tauntonme/General/Electronics Hardware/Signals Controller/DaisyCore/Daisies3.jpg

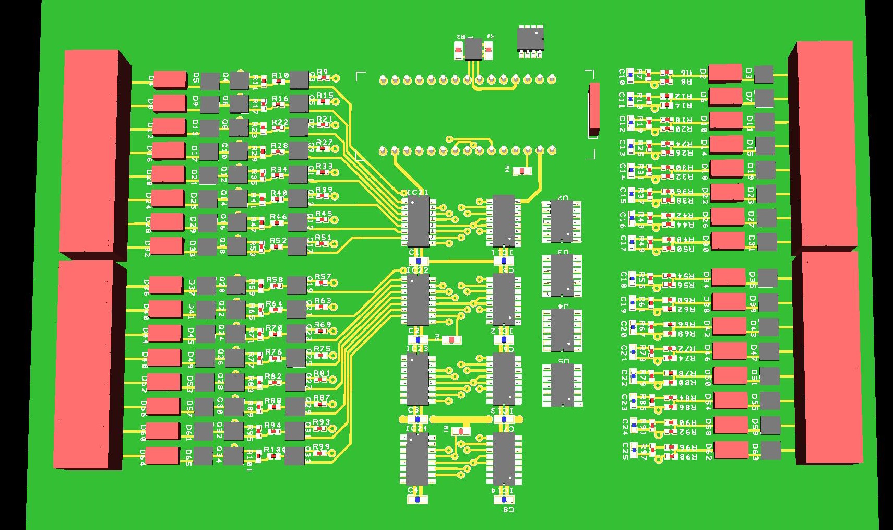
Electronics Hardware/Signals Controller/DaisyCore/Daisies3.jpg
