tauntonme/General/README.md

# General
First landing place for all files for now, will refine later maybe

Created by Jon Freeman
23rd May 2023
