tauntonme/General/Electronics Hardware/Signals Controller/DaisyCore/Daisy.odt

West Buckland Railway Signalling System

System Architecture Overview

The purpose of the Signalling System is to promote safer working of the railways.

Signalling. A Control System.

The railway is made up of a number of discrete connected ‘objects’; track sections, turnouts, crossing gates, lineside railway signals, train presence or movement detectors to name a few, and the ‘whatever it is that makes it all work’ controller(s).

A control system monitors the state of ‘objects’, and determines the future state of these and other objects in accordance with some predetermined plan, or ‘programme’. This, in essence, describes any control system whether a railway signalling system, oil refinery, or other process.

There’s plenty that moves on a railway, apart from trains! Gates, turnouts and semaphore signals, for example. To keep collision numbers low, the signalling system needs to ‘know’ for certain where all these moving items are at any time.

You might imagine that as the signalling system directs the settings of semaphores and turnouts, a simple one-wire ‘On/Off’ command

The simplest approach to controlling these might involve switching power along single wires to move object parts, in the hope that a semaphore moves between showing ‘Clear’ or Danger’, a turnout moves from setting ‘Safe Route A’ to setting ‘Safe Route B’, a gate moves between being fully open to fully shut, with power sent along the appropriate wire, or not.

There’s plenty to go wrong here. A gull sitting on a semaphore blade, a pebble stuck in a turnout, something blocking a gate, a semaphore missing altogether – the controller needs to know!

Object parts may be moved using motors, solenoids, pneumatics, or something else. There may be the need to drive actuators in both directions, requiring at least a two-wire control – two outputs from the controller. For the controller to be certain of the position objects are in, two inputs to the controller are required (see ‘Moving Part Rule’ and ‘Standard Interface’ for details). This 2-in, 2-out requirement uses ‘4IO’ in the jargon. Using the ‘Standard Interface’, 4 controller ‘IO’ lines need to be allocated to each moving object.

A quick count-up for a rough guide to controller ‘IO’ requirement : - 8 turnouts, maybe 18 semaphore or coloured light equivalent lineside signals, 4 crossing gates = 30 objects requiring a total 120 IO.

A lineside railway signal may, for example, indicate “Clear” or “Danger”. Having no means within itself to determine which aspect to display, it obeys a command decision issued to it by a ‘controller’, which uses knowledge of the states found in the wider system in reaching its decision.

For semaphore signals, and other objects with moving parts, the controller will also need to ‘know’ the part has moved correctly and fully to the required position. Movement command and position feedback between controller and remote ‘object’ typically uses four wires, two input and two output (“4 IO” to use the jargon) as detailed in ‘Standard Interface link’.

Turnouts (points). The controller constantly needs to know with certainty the turnout is ‘In Position A’, is ‘In Position B’, or in neither of the above! Semaphore signals, mechanical interlocks and crossing gates are other examples of objects that the controller needs to know the position state of. Consideration of these led to the ‘Moving Part Rule’ for safely reporting positions back to the controller. Whatever means of setting turnout position is decided upon, there will be times when attempted setting fails (pebble stuck in works?). One task of the SigSys is to ensure failures of this and similar types are dealt with safely.

Electronics and Controllers

Safe running of the railway relies upon factors both within, and beyond our field of influence. While design and testing of signalling system outputs will be rigorously tested and formed to comply with agreed requirements, it is inevitable ‘Signals At Danger’ will be passed, and unmonitored other hazards will arise.

hite

Controllers and Peripherals

Lineside driver-info signals, turnouts determining route, level crossing, signal box levers – these system component parts are the ‘peripherals’.

Monitoring and changing the states of peripherals will be one or more ‘controller’.

The Signalling System comprises ‘Controllers’ and ‘Peripherals’.

A controller has a point-to-point, two-way communication channel with each peripheral within its world view. Peripherals communicate with one controller only. This describes a ‘Star Network (https://en.wikipedia.org/wiki/Star_network)’.

The signalling system design and build will evolve, and is likely to include more than one controller. The controllers will also be considered a ‘Star Network’, with one designated the central hub. Thus there are at most three levels of hierarchy.

Comms between controllers requires some protocol for interchange of messages of variable lengths and types, deliverable over a physical layer being CAN bus or other two-wire or radio serial bus, or combination thereof.

Most peripherals are very simple, having no ‘intelligence’, and tend to be positioned close to a controller. It makes sense to hard-wire simple nearby peripherals to the controller. To this end, a ‘Standard 2-in-2-out Interface (https://jons-workshop.com/wbsigs/std_interface.html)’ is presented (see also the Moving Part Rule (https://jons-workshop.com/wbsigs/moving_part_rule.html).)

Cable Connections

Electrical signal-wire connections will be used between items distributed around a ‘harsh environment’, with attendant risk to electrical signal and cable integrity. Electrical interfaces will be designed such that a cable fault between a controller and a peripheral, however caused, will : -

- cause no damage to interfaces in the controller or the peripheral
- affect only the connected peripheral

The one exception to be partial or total power failure. Power is likely to be distributed using a power distribution network, separate from controller network cabling. Cable faults on the power network may shut down the whole system, the cost of alternative power distribution topologies being prohibitive.

West Buckland Railways - Signalling

Standard Control Interface – Electrical Specification

Jon Freeman 30th March 2023

This document contains the electrical specifications of electrical Input and Output ports of Controllers and Peripherals used in the signalling system.

Design considerations : -

(Reference to ‘signal’ in this section means ‘electrical signal’.)

Notes on WBSIG ‘Daisy’ Controller

Jon Freeman Feb 2023

This describes the West Buckland Railway signalling system sub-assembly ‘Daisy’.

The unit features a controller, connected to a number of input and output connections.

Inputs are used to monitor limit switches or other sensors providing feedback of information about the physical positions of things such as gates, levers, turnout settings, semaphores etc.

Outputs may be used to drive coloured light or semaphore signals, actuators for gates and turnouts etc.

The controller will set outputs according to the current state of inputs, as determined by a set of instructions distilled from the collective wisdom of club members..

SIPO - Serial in, parallel out

PISO - Parallel in, serial out

A Nucleo L432KC ARM Cortex controller is connected to a pair of daisy-chains of shift registers : -

- SIPO Chain - Provides Logic Outputs useful for powering lights, actuators etc
- PISO Chain - Reads and stores Logic Inputs from limit switches etc.

The SIPO chain uses 74HC595 serial-in parallel-out shift registers.

The PISO chain uses 74HC597 parallel-in serial-out shift registers.

Chain length can in principle be any (on this board, four 8-bit registers are used in each chain giving 32 input and 32 output bits).

The controller loads the output registers, and reads the input registers simultaneously using an internal SPI engine (Serial Peripheral Interface), under interrupt control. This reduces overhead to almost nothing (does not tie-up the processor clocking bits in and out).

595 SIPO - for Outputs

Comprises : -

8 stage SIPO shift register

8 bit storage registers

8 bit tri-state output buffer

Inputs

DS from controller MOSI or Q7 of previous stage, Data Serial In to shift reg

SHCP Shift Clk __-- moves bits along shift register

MR\ Clear shift reg only contents

STCP Storage register strobe _- updates from shift reg output

OE\ Output enable, active Lo

Outputs

Q0-Q7 8 bit tri-state buffer outputs

Q7S Shift reg MSB out to DS of following stage

597 PISO - for Inputs

Comprises : -

8 bit input register, feeding

8 bit shift register

13 Inputs

D0-D7 8 bit input

STCP storage register clk, _- loads 8 bit input to shift register

MR\ Async reset

DS Data in from previous stage

PL\ Async load shift reg from storage reg

SHCP shift register clk _-

1 Output

Q7 to controller MISO or DS input of next stage in chain

SHCP

For both ‘595 and ‘597, _- shift register clock from SPI_SCLK

STCP

For ‘595 outputs. _- clocks shift reg data onto outputs

For ‘597 inputs, _- clocks data into input flip flops

PL\

‘597 input only. Active low async parallel load shift reg from input register. This could be combined with STCP if STCP idles hi ------_----, except that PL\ becomes active after falling edge, inactive on rising edge when later info updates input flip flops. This means input flip flops always read data one cycle later, although STCP could be driven ----_-_---- where the extra rising clock edge transfers latest input data, double clocking output data has no effect.

MR\ (‘597 input and ‘595 output)

Async master shift register reset. Good practice, perhaps, to pull low during power-up. To remain hi in normal use. Probably good to tie to NRTS. R4, R5, C9 provide options.

OE\ (‘595 output only)

Pull low, use 1k resistor. Do not expect problems with outputs enabled at all times, pull-down keeps options open.

West Buckland Railway Signalling Project

All About Controllers

The signalling system uses one or more controllers programmed to our needs. The heart of any controller box will be a small central mini-computer with few connections. Strings, or ‘daisy chains’ of shift-registers are used to provide any practical number of ‘input’ and ‘output’ connections to monitor and control the wider system. Referring to Fig “Controller Core”, the mini-computer is a low cost (£10) module U1 STM32L432KC. It connects to; IC1 a memory to store local setup info, IC3 a CAN bus interface enabling communication between controllers, and to the right two ‘daisy chains’ of shift registers enabling reading and setting of any practical number of input and output connections (two chains of four eight-bit registers shown, providing 32 inputs and 32 outputs. Daisy chains may be any practical length for any practical number of connections).

Controller Input and Output Interface Circuits

The tiny electrical signals powering modern digital systems need a good degree of protection and isolation from the Big Bad World, to and from which they ultimately communicate. This is the job of the input and output interface circuits.

Q. How much money do we want to spend on In/Out interfacing?

A. While not driven as a ‘cost sensitive’ project, the total number of inputs and outputs proposed has been greatly inflated by our accommodation of a lot of extra mechanical hardware. Raised track requirements are trivial, but long before design of the ground-level system is anywhere near complete, combined I/O requirements exceed one hundred – a penny saved on I/O design saves the club > £1.

Agreed early on, the highest voltage used in the signalling system is +50V DC (negative earth). Input and output circuits will be designed to withstand max system voltages being wrongly applied.

Faulty connection of any input or output is to cause no damage, and have no effect on any other input or output. Allowing for a +50% voltage safety margin, there should be no need to resort to costly hardware such as opto-isolation, multiple floating I/O supplies etc.

Source(s) and Sink(s).

These are terms used in discussion of controller inputs and outputs. Simply, a ‘source’ is an electrical terminal capable of ‘sourcing’ a conventional current flow towards a more electrically negative terminal, the ‘sink’. Conventional current is said to flow from positive, to negative. Current flows from source, to sink. Just like water and taps, no more difficult than that.

Should our inputs and outputs be ‘sources’ or ‘sinks’ ?

As a design nicety, we will specify that any input should correctly read any output to which it may be connected. This implies one is a ‘source’, the other a ‘sink’. It makes not a scrap of difference which. Controllers in the West Buckland Signalling system will use current source outputs, and current sink inputs. What this means : -

Inputs sink current. Unconnected inputs or those with zero (or a very small) current flowing into the input connection will be seen by the controller as a logic ‘0’. A positive voltage (in the range around +8 to + 80 volts) applied to the input causes sufficient current to flow into the input sink for the controller to read it as logic ‘1’. What these logic levels mean in terms of signalling will depend upon expressions forming the control algorithm used to determine signalling system behaviour, not our concern here.

Outputs source current. When the controller sets an output bit to ‘1’, current may be drawn from that output connection – e.g. connect an LED between the output pin and earth, current flows, LED lights. With the output bit set to ‘0’, no current flows, LED is dark.

Circuit Protection

Input and output circuits must not be damaged by wrong connection or cable faults. Outputs will be limited in the power they may ‘source’, as it is not reasonable to expect a controller to power any size and type of load a user might one day decide to connect. Rather the outputs will be specified sufficient to power small loads directly, and to operate higher power loads using power switching circuits local to the load, as is good practice.

Inputs and outputs utilise DC, positive with respect to ‘ground’ (negative earth). Protection will be rated to continuously withstand short circuits on individual inputs and outputs to potential points between 0 and +75V (for short term ‘ESD’ ratings see component data sheets).

Interface Design – refer to figure “WBSigs_IO_detail”.

Input Interface Circuit Design

Inputs are designed to sink currents up to 5.6mA (+/- 20%). This is defined and limited using current regulator diodes CL05M6F (See datasheet (https://www.mouser.co.uk/datasheet/2/849/cl05m6f-2577303.pdf)). Referring to Fig “WBSigs_IO_detail”, D2 is an input current regulator, D3 is a plain diode protecting against reverse polarity voltages applied to inputs. Resistor network R6-8 convert input current to a low level voltage fed to Schmitt trigger (https://en.wikipedia.org/wiki/Schmitt_trigger) 74HC14, which buffers the input signal and presents it to the input shift registers. This provides some hysteresis to overcome any noise present on input wiring, meaning the input may read as a logic ‘1’ when input current rises above about 4mA but will not revert to ‘0’ until input current falls below around 2.5mA. Capacitor C10 filters out higher frequencies – prevents interference from radio and other noisy electrical equipment.

Output Interface Circuit Design

Outputs are designed to source currents up to about 15mA, limited by current regulator diode D4 (CL15M35, see data (https://www.mouser.co.uk/datasheet/2/849/cl20m35-2845309.pdf)). This choice ensures an input connected directly to an output, will read the true state. Referring to the circuit, transistor Q3 and resistor R9 form a switched current sink capable of sinking about 1mA when the connected output shift register bit is set to ‘1’. This is sufficient to bias transistor Q4 ‘on’, enabling it to source currents in excess of 15mA. D4 limits current to safe levels. D5 protects against output shorts to high voltage.

Note this input and output circuitry is about as simple as possible consistent with safety and protection requirements, interface component costs of the order of <£2 per IO pair. This is replicated for the number of inputs and outputs, apart from the 74HC14, a hex Schmitt trigger, which can route 6 input bits to the input shift registers. (One of six inverters per 74HC14 shown).
