tauntonme/General/Electronics Hardware/Signals IO Expander/DaisyIOFINAL/plots/DaisyIOFINAL (Plot Report).htm

## Plot Report

Report Written: | Wednesday, May 31, 2023
Project Path: | C:\EasyPC_Projects_Oct22\DaisyIOFINAL\DaisyIOFINAL.prj
Design Path: | C:\EasyPC_Projects_Oct22\DaisyIOFINAL\DaisyIOFINAL.pcb
Design Title:
Created: | 28/05/2023 11:32:32
Last Saved: | 31/05/2023 15:01:09
Editing Time: | 3738 min
Units: | thou (precision 0)

## Device Settings

### Gerber Settings

Leading zero suppression.
G01 assumed throughout.
Line termination <*> .
3.5 format absolute inches.
Format commands defined in Gerber file.
Aperture table defined in Gerber file.
Hardware arcs allowed.

### Drill Settings

Excellon Format 2
Format 3.5 absolute in inches.
Zero suppression Leading

## Plots Output

### Gerber Output

C:\EasyPC_Projects_Oct22\DaisyIOFINAL\Plots\DaisyIOFINAL - Top Silk.gbr

Layers:
Top Silk

D-Code | Shape (thou)
D14 | Round 3.94
D18 | Round 7.87
D19 | Round 5.00
D70 | Round 15.75

### Gerber Output

C:\EasyPC_Projects_Oct22\DaisyIOFINAL\Plots\DaisyIOFINAL - Top Copper.gbr

Layers:
Top Copper

D-Code | Shape (thou)
D23 | Round 15.00
D24 | Round 48.00
D25 | Round 25.00
D26 | Round 50.00
D27 | Round 56.00
D29 | Square 45.00
D72 | Rectangle 40.00 X 48.00 Rotation 90
D73 | Rectangle 40.00 X 44.00
D74 | Square 76.77
D75 | Round 76.77
D76 | Round 63.19
D90 | Rectangle 61.02 X 78.74 Rotation 90
D91 | Rectangle 39.37 X 42.91 Rotation 90
D98 | Round 100.00
D99 | Round 40.00
D100 | Round 20.00
D101 | Round 150.00
D102 | Round 260.00
D103 | Rectangle 180.00 X 460.00 Rotation 90
D104 | Round 96.00
D105 | Rectangle 27.56 X 61.02 Rotation 90
D106 | Square 63.00
D107 | Round 55.00

### Gerber Output

C:\EasyPC_Projects_Oct22\DaisyIOFINAL\Plots\DaisyIOFINAL - Top Resist.gbr

Layers:
Top Resist

D-Code | Shape (thou)
D10 | Round 58.00
D11 | Round 66.00
D78 | Square 55.00
D79 | Rectangle 50.00 X 58.00 Rotation 90
D80 | Rectangle 50.00 X 54.00
D81 | Square 86.77
D82 | Round 86.77
D83 | Round 73.19
D94 | Rectangle 71.02 X 88.74 Rotation 90
D95 | Rectangle 49.37 X 52.91 Rotation 90
D108 | Round 270.00
D109 | Round 106.00
D110 | Rectangle 37.56 X 71.02 Rotation 90
D111 | Square 73.00
D112 | Round 65.00

### Gerber Output

C:\EasyPC_Projects_Oct22\DaisyIOFINAL\Plots\DaisyIOFINAL - Bottom Copper.gbr

Layers:
Bottom Copper

D-Code | Shape (thou)
D23 | Round 15.00
D24 | Round 48.00
D25 | Round 25.00
D26 | Round 50.00
D27 | Round 56.00
D72 | Rectangle 40.00 X 48.00 Rotation 90
D73 | Rectangle 40.00 X 44.00
D74 | Square 76.77
D75 | Round 76.77
D76 | Round 63.19
D88 | Rectangle 27.56 X 76.77 Rotation 90
D89 | Rectangle 40.00 X 44.00 Rotation 90
D90 | Rectangle 61.02 X 78.74 Rotation 90
D91 | Rectangle 39.37 X 42.91 Rotation 90
D102 | Round 260.00
D104 | Round 96.00
D105 | Rectangle 27.56 X 61.02 Rotation 90
D107 | Round 55.00
D113 | Round 60.00

### Gerber Output

C:\EasyPC_Projects_Oct22\DaisyIOFINAL\Plots\DaisyIOFINAL - Bottom Resist.gbr

Layers:
Bottom Resist

D-Code | Shape (thou)
D10 | Round 58.00
D11 | Round 66.00
D79 | Rectangle 50.00 X 58.00 Rotation 90
D80 | Rectangle 50.00 X 54.00
D81 | Square 86.77
D82 | Round 86.77
D83 | Round 73.19
D92 | Rectangle 37.56 X 86.77 Rotation 90
D93 | Rectangle 50.00 X 54.00 Rotation 90
D94 | Rectangle 71.02 X 88.74 Rotation 90
D95 | Rectangle 49.37 X 52.91 Rotation 90
D108 | Round 270.00
D109 | Round 106.00
D110 | Rectangle 37.56 X 71.02 Rotation 90
D112 | Round 65.00

### Gerber Output

C:\EasyPC_Projects_Oct22\DaisyIOFINAL\Plots\DaisyIOFINAL - Bottom Silk.gbr

Layers:
Bottom Silk

D-Code | Shape (thou)
D18 | Round 7.87
D19 | Round 5.00

### Gerber Output

C:\EasyPC_Projects_Oct22\DaisyIOFINAL\Plots\DaisyIOFINAL - Documentation.gbr

Layers:
Documentation

D-Code | Shape (thou)
D13 | Round 1.97
D14 | Round 3.94

### Gerber Output

C:\EasyPC_Projects_Oct22\DaisyIOFINAL\Plots\DaisyIOFINAL - Gerber Drill Data - [Through Hole].gbr

Layers:
[Through Hole]

D-Code | Shape (thou)
D15 | Round 24.00
D16 | Round 32.00
D96 | Round 51.18
D97 | Round 42.13
D114 | Round 135.00
D115 | Round 45.00
D116 | Round 42.00

### NC Drill Output

C:\EasyPC_Projects_Oct22\DaisyIOFINAL\Plots\DaisyIOFINAL - NC Drill Data - [Through Hole].drl

Output:

Plated Round Drill Holes

Plated Slots

Plated Board Outlines

Tool | Size | Count | ID
T001 | 0.02400 inches | 75 | A
T002 | 0.03200 inches | 32 | D
T003 | 0.04200 inches | 4 | I
T004 | 0.04213 inches | 32 | M
T005 | 0.04500 inches | 16 | O
T006 | 0.05118 inches | 32 | L
T007 | 0.13500 inches | 4 | N
Total | | 195

C:\EasyPC_Projects_Oct22\DaisyIOFINAL\Plots\DaisyIOFINAL - NC Drill Data - [Through Hole] (Unplated).drl

Output:

Unplated Round Drill Holes

Unplated Slots

Unplated Board Outlines

Tool | Size | Count | ID
T001 | 0.02500 inches | 1
Total | | 1

### Gerber Output

C:\EasyPC_Projects_Oct22\DaisyIOFINAL\Plots\DaisyIOFINAL - Drill Ident Drawing - [Through Hole].gbr

Layers:
[Through Hole]
Board Outlines

### Drill Ident Drawing

Drill | Plated | Size | Shape | ID
24 | Y | 100 | Round | A
32 | Y | 100 | Round | D
42 | Y | 100 | Round | I
51 | Y | 100 | Round | L
42 | Y | 100 | Round | M
135 | Y | 100 | Round | N
45 | Y | 100 | Round | O

D-Code | Shape (thou)
D19 | Round 5.00
D98 | Round 100.00
