tauntonme/General/Electronics Hardware/Signals Controller/DaisyCore/Plots/Daisies (Plot Report).htm

## Plot Report

Report Written: | Thursday, April 27, 2023
Project Path: | C:\EasyPC_Projects_Oct22\Daisy\Daisies.prj
Design Path: | C:\EasyPC_Projects_Oct22\Daisy\Daisies.pcb
Design Title:
Created: | 11/02/2023 17:45:12
Last Saved: | 27/04/2023 19:07:24
Editing Time: | 58858 min
Units: | thou (precision 0)

## Device Settings

### Gerber Settings

Leading zero suppression.
G01 assumed throughout.
Line termination <*> .
3.5 format absolute inches.
Format commands defined in Gerber file.
Aperture table defined in Gerber file.
Hardware arcs allowed.

### Drill Settings

Excellon Format 2
Format 3.5 absolute in inches.
Zero suppression Leading

### PDF Settings

Combine Plots Yes
Use Bookmarks Yes
Component Details Yes
Symbol Details Yes
Link Net Names Yes
View PDF Yes
All Colours Black No
Embed Fonts Yes

## Plots Output

### PDF Output

Layer

Top Silk

### Gerber Output

C:\EasyPC_Projects_Oct22\Daisy\Plots\Daisies - Top Paste.gbr

Layers:
Top Paste

D-Code | Shape (thou)
D116 | Rectangle 30.12 X 34.06
D117 | Rectangle 23.03 X 58.46
D118 | Rectangle 21.26 X 52.76 Rotation 90
D119 | Rectangle 24.80 X 57.40 Rotation 90
D120 | Rounded Rectangle 55.00 X 56.00 X 10.00 Rotation 90
D121 | Rectangle 31.89 X 43.70 Rotation 90
D130 | Rectangle 28.35 X 32.28
D131 | Rectangle 49.50 X 54.50
D132 | Rounded Rectangle 55.00 X 56.00 X 10.00
D133 | Rectangle 54.92 X 72.64 Rotation 90
D134 | Rectangle 54.92 X 72.64
D135 | Rectangle 22.50 X 77.50
D136 | Rectangle 36.00 X 44.00
D137 | Rectangle 35.43 X 38.98 Rotation 90
D138 | Rectangle 30.12 X 34.06 Rotation 90

### Gerber Output

C:\EasyPC_Projects_Oct22\Daisy\Plots\Daisies - Top Copper.gbr

Layers:
Top Copper

D-Code | Shape (thou)
D18 | Round 50.00
D19 | Round 15.00
D22 | Round 25.00
D25 | Round 60.00
D26 | Round 56.00
D89 | Rectangle 23.62 X 55.12 Rotation 90
D90 | Rectangle 33.46 X 37.40
D92 | Rectangle 33.46 X 37.40 Rotation 90
D122 | Round 48.00
D128 | Rectangle 40.00 X 48.00
D139 | Rectangle 25.59 X 61.02
D140 | Rectangle 27.56 X 60.16 Rotation 90
D141 | Rounded Rectangle 55.00 X 56.00 X 10.00 Rotation 90
D142 | Rectangle 35.43 X 47.24 Rotation 90
D143 | Rectangle 31.50 X 35.43
D144 | Rectangle 55.00 X 60.00
D145 | Rounded Rectangle 55.00 X 56.00 X 10.00
D146 | Rectangle 61.02 X 78.74 Rotation 90
D147 | Rectangle 61.02 X 78.74
D148 | Rectangle 25.00 X 80.00
D149 | Rectangle 39.37 X 42.91 Rotation 90

### Gerber Output

C:\EasyPC_Projects_Oct22\Daisy\Plots\Daisies - Top Resist.gbr

Layers:
Top Resist

D-Code | Shape (thou)
D10 | Round 58.00
D16 | Rectangle 50.00 X 58.00
D150 | Round 66.00
D151 | Round 70.00
D152 | Rectangle 35.59 X 71.02
D153 | Rectangle 33.62 X 65.12 Rotation 90
D154 | Rectangle 37.56 X 70.16 Rotation 90
D155 | Rounded Rectangle 55.00 X 56.00 X 10.00 Rotation 90
D156 | Rectangle 45.43 X 57.24 Rotation 90
D157 | Rectangle 41.50 X 45.43
D158 | Rectangle 65.00 X 70.00
D159 | Rounded Rectangle 55.00 X 56.00 X 10.00
D160 | Rectangle 71.02 X 88.74 Rotation 90
D161 | Rectangle 71.02 X 88.74
D162 | Rectangle 35.00 X 90.00
D163 | Rectangle 49.37 X 52.91 Rotation 90
D164 | Rectangle 43.46 X 47.40 Rotation 90
D165 | Rectangle 43.46 X 47.40

### Gerber Output

C:\EasyPC_Projects_Oct22\Daisy\Plots\Daisies - Bottom Copper.gbr

Layers:
Bottom Copper

D-Code | Shape (thou)
D18 | Round 50.00
D19 | Round 15.00
D25 | Round 60.00
D26 | Round 56.00
D122 | Round 48.00

### Gerber Output

C:\EasyPC_Projects_Oct22\Daisy\Plots\Daisies - Bottom Resist.gbr

Layers:
Bottom Resist

D-Code | Shape (thou)
D10 | Round 58.00
D11 | Round 66.00
D12 | Round 70.00

### Gerber Output

C:\EasyPC_Projects_Oct22\Daisy\Plots\Daisies - Documentation.gbr

Layers:
Documentation

D-Code | Shape (thou)
D13 | Round 1.97
D14 | Round 3.94

### Gerber Output

C:\EasyPC_Projects_Oct22\Daisy\Plots\Daisies - Gerber Drill Data - [Through Hole].gbr

Layers:
[Through Hole]

D-Code | Shape (thou)
D15 | Round 24.00
D16 | Round 32.00
D17 | Round 38.00

### NC Drill Output

C:\EasyPC_Projects_Oct22\Daisy\Plots\Daisies - NC Drill Data - [Through Hole].drl

Output:

Plated Round Drill Holes

Plated Slots

Plated Board Outlines

Tool | Size | Count | ID
T001 | 0.02400 inches | 41 | A
T002 | 0.03200 inches | 4 | D
T003 | 0.03800 inches | 30 | K
Total | | 75

C:\EasyPC_Projects_Oct22\Daisy\Plots\Daisies - NC Drill Data - [Through Hole] (Unplated).drl

Output:

Unplated Round Drill Holes

Unplated Slots

Unplated Board Outlines

Tool | Size | Count | ID
T001 | 0.02500 inches | 1
Total | | 1

### PDF Output

Layer

### Drill Ident Drawing

Drill | Plated | Size | Shape | ID
24 | Y | 100 | Round | A
32 | Y | 100 | Round | D
38 | Y | 100 | Round | K
