tauntonme/General/Electronics Hardware/Signals Controller/DaisyCore/Plots/DaisyCore (Plot Report).htm

## Plot Report

Report Written: | Wednesday, May 31, 2023
Project Path: | C:\EasyPC_Projects_Oct22\DaisyCore\DaisyCore.prj
Design Path: | C:\EasyPC_Projects_Oct22\DaisyCore\DaisyCore.pcb
Design Title:
Created: | 11/02/2023 17:45:12
Last Saved: | 31/05/2023 15:37:27
Editing Time: | 73774 min
Units: | thou (precision 0)

## Device Settings

### Gerber Settings

Leading zero suppression.
G01 assumed throughout.
Line termination <*> .
3.5 format absolute inches.
Format commands defined in Gerber file.
Aperture table defined in Gerber file.
Hardware arcs allowed.

### Drill Settings

Excellon Format 2
Format 3.5 absolute in inches.
Zero suppression Leading

## Plots Output

### Gerber Output

C:\EasyPC_Projects_Oct22\DaisyCore\Plots\DaisyCore - Top Silk.gbr

Layers:
Top Silk

D-Code | Shape (thou)
D14 | Round 3.94
D18 | Round 7.87
D19 | Round 5.00
D70 | Round 15.75
D117 | Round 10.00

### Gerber Output

C:\EasyPC_Projects_Oct22\DaisyCore\Plots\DaisyCore - Top Copper.gbr

Layers:
Top Copper

D-Code | Shape (thou)
D23 | Round 15.00
D24 | Round 48.00
D25 | Round 25.00
D26 | Round 50.00
D27 | Round 56.00
D76 | Round 63.19
D102 | Round 260.00
D106 | Square 63.00
D113 | Round 60.00
D118 | Rectangle 160.00 X 200.00
D119 | Rectangle 55.00 X 60.00 Rotation 90
D120 | Rounded Rectangle 55.00 X 56.00 X 10.00
D121 | Rectangle 25.59 X 60.04
D122 | Round 58.19
D123 | Rectangle 27.56 X 60.16 Rotation 90
D124 | Square 60.00
D125 | Round 70.00
D126 | Round 175.00

### Gerber Output

C:\EasyPC_Projects_Oct22\DaisyCore\Plots\DaisyCore - Top Resist.gbr

Layers:
Top Resist

D-Code | Shape (thou)
D10 | Round 58.00
D11 | Round 66.00
D12 | Round 70.00
D83 | Round 73.19
D108 | Round 270.00
D111 | Square 73.00
D127 | Rectangle 170.00 X 210.00
D128 | Rectangle 65.00 X 70.00 Rotation 90
D129 | Rounded Rectangle 55.00 X 56.00 X 10.00
D130 | Rectangle 35.59 X 70.04
D131 | Round 68.19
D132 | Rectangle 37.56 X 70.16 Rotation 90
D133 | Square 70.00
D134 | Round 80.00
D135 | Round 185.00

### Gerber Output

C:\EasyPC_Projects_Oct22\DaisyCore\Plots\DaisyCore - Bottom Copper.gbr

Layers:
Bottom Copper

D-Code | Shape (thou)
D23 | Round 15.00
D24 | Round 48.00
D25 | Round 25.00
D26 | Round 50.00
D27 | Round 56.00
D76 | Round 63.19
D102 | Round 260.00
D106 | Square 63.00
D113 | Round 60.00
D118 | Rectangle 160.00 X 200.00
D119 | Rectangle 55.00 X 60.00 Rotation 90
D122 | Round 58.19
D124 | Square 60.00
D125 | Round 70.00
D126 | Round 175.00
D136 | Rectangle 23.62 X 55.12 Rotation 90
D137 | Rounded Rectangle 55.00 X 56.00 X 10.00 Rotation 90
D138 | Rectangle 55.00 X 60.00
D139 | Rectangle 21.65 X 41.34 Rotation 90

### Gerber Output

C:\EasyPC_Projects_Oct22\DaisyCore\Plots\DaisyCore - Bottom Resist.gbr

Layers:
Bottom Resist

D-Code | Shape (thou)
D10 | Round 58.00
D11 | Round 66.00
D12 | Round 70.00
D83 | Round 73.19
D108 | Round 270.00
D111 | Square 73.00
D127 | Rectangle 170.00 X 210.00
D128 | Rectangle 65.00 X 70.00 Rotation 90
D131 | Round 68.19
D133 | Square 70.00
D134 | Round 80.00
D135 | Round 185.00
D140 | Rectangle 33.62 X 65.12 Rotation 90
D141 | Rounded Rectangle 55.00 X 56.00 X 10.00 Rotation 90
D142 | Rectangle 65.00 X 70.00
D143 | Rectangle 31.65 X 51.34 Rotation 90

### Gerber Output

C:\EasyPC_Projects_Oct22\DaisyCore\Plots\DaisyCore - Bottom Silk.gbr

Layers:
Bottom Silk

D-Code | Shape (thou)
D18 | Round 7.87
D19 | Round 5.00

### Gerber Output

C:\EasyPC_Projects_Oct22\DaisyCore\Plots\DaisyCore - Documentation.gbr

Layers:
Documentation

D-Code | Shape (thou)
D13 | Round 1.97
D14 | Round 3.94

### Gerber Output

C:\EasyPC_Projects_Oct22\DaisyCore\Plots\DaisyCore - Gerber Drill Data - [Through Hole].gbr

Layers:
[Through Hole]

D-Code | Shape (thou)
D15 | Round 24.00
D16 | Round 32.00
D17 | Round 38.00
D97 | Round 42.13
D114 | Round 135.00
D144 | Round 35.00
D145 | Round 37.40
D146 | Round 37.00
D147 | Round 100.00

### NC Drill Output

C:\EasyPC_Projects_Oct22\DaisyCore\Plots\DaisyCore - NC Drill Data - [Through Hole].drl

Output:

Plated Round Drill Holes

Plated Slots

Plated Board Outlines

Tool | Size | Count | ID
T001 | 0.02400 inches | 15 | A
T002 | 0.03200 inches | 17 | D
T003 | 0.03500 inches | 14 | G
T004 | 0.03700 inches | 9 | Q
T005 | 0.03740 inches | 2 | P
T006 | 0.03800 inches | 30 | K
T007 | 0.04213 inches | 16 | M
T008 | 0.10000 inches | 2 | B
T009 | 0.13500 inches | 4 | N
Total | | 109

C:\EasyPC_Projects_Oct22\DaisyCore\Plots\DaisyCore - NC Drill Data - [Through Hole] (Unplated).drl

Output:

Unplated Round Drill Holes

Unplated Slots

Unplated Board Outlines

Tool | Size | Count | ID
T001 | 0.02500 inches | 1
Total | | 1

### Gerber Output

C:\EasyPC_Projects_Oct22\DaisyCore\Plots\DaisyCore - Drill Ident Drawing - [Through Hole].gbr

Layers:
[Through Hole]
Board Outlines

### Drill Ident Drawing

Drill | Plated | Size | Shape | ID
24 | Y | 100 | Round | A
100 | Y | 100 | Round | B
32 | Y | 100 | Round | D
35 | Y | 100 | Round | G
38 | Y | 100 | Round | K
42 | Y | 100 | Round | M
135 | Y | 100 | Round | N
37 | Y | 100 | Round | P
37 | Y | 100 | Round | Q

D-Code | Shape (thou)
D19 | Round 5.00
D98 | Round 100.00
