tauntonme/General/General_README.md

# General
Taunton Model Engineers - Signalling at West Buckland

Look at the dates anything was last updated and decide for yourself how useful you think it might be.

The 'General' repository is for collaborative working involving interested members of TME.
As a 'Public' resource, contents here are available for tout le monde to read.

Any TME member wishing to join, contact J.F.

Created by Jon Freeman
23rd May 2023
