tauntonme/General/Electronics Hardware/Signals Controller/DaisyCore/Plots/Daisies_Ins (Plot Report).htm

## Plot Report

Report Written: | Thursday, March 30, 2023
Project Path: | C:\EasyPC_Projects_Oct22\Daisy\Daisies.prj
Design Path: | C:\EasyPC_Projects_Oct22\Daisy\Daisies_Ins.sch
Design Title:
Created:
Last Saved: | 30/03/2023 11:04:40
Editing Time: | 1235 min
Units: | thou (precision 2)

## Device Settings

### PDF Settings

Combine Plots Yes
Use Bookmarks Yes
Component Details Yes
Symbol Details Yes
Link Net Names Yes
View PDF Yes
All Colours Black No
Embed Fonts Yes

## Plots Output

### PDF Output

Layer

##### PLOT INCOMPLETE #####
