tauntonme/General/Electronics Hardware/Signals Controller/DaisyCore/Daisies.jpg

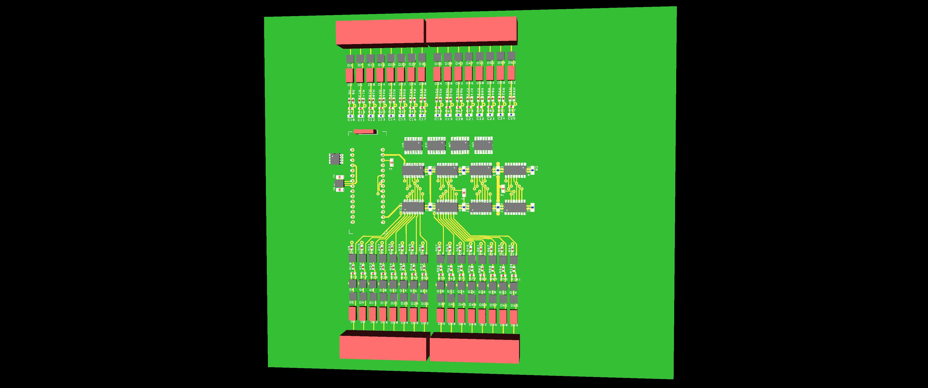
Electronics Hardware/Signals Controller/DaisyCore/Daisies.jpg
