tauntonme/General/Electronics Hardware/Signals Controller/DaisyCore/Plots/Controller Core.png

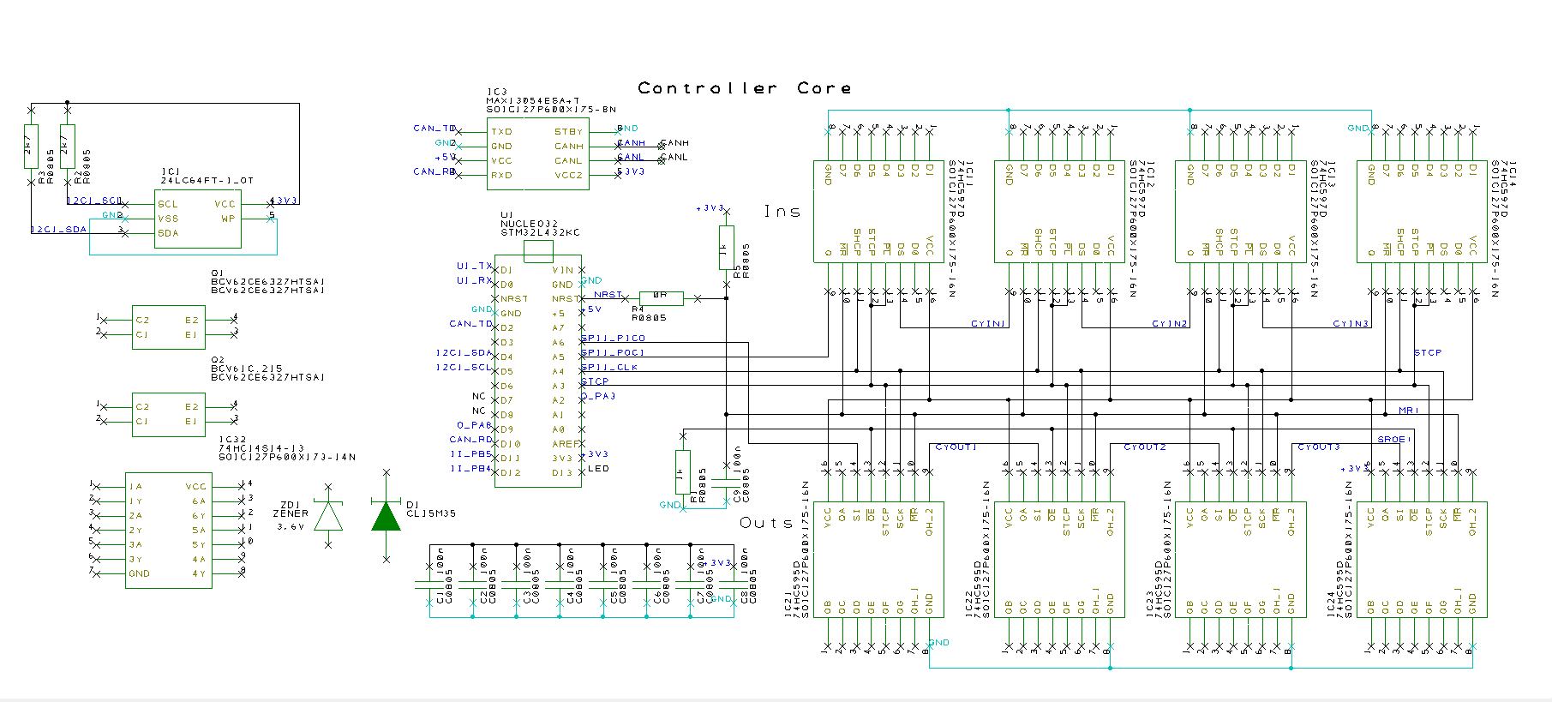
Electronics Hardware/Signals Controller/DaisyCore/Plots/Controller Core.png
