tauntonme/General/Electronics Hardware/Signals Controller/DaisyCore/Plots/WBSigs_IO_detail.png

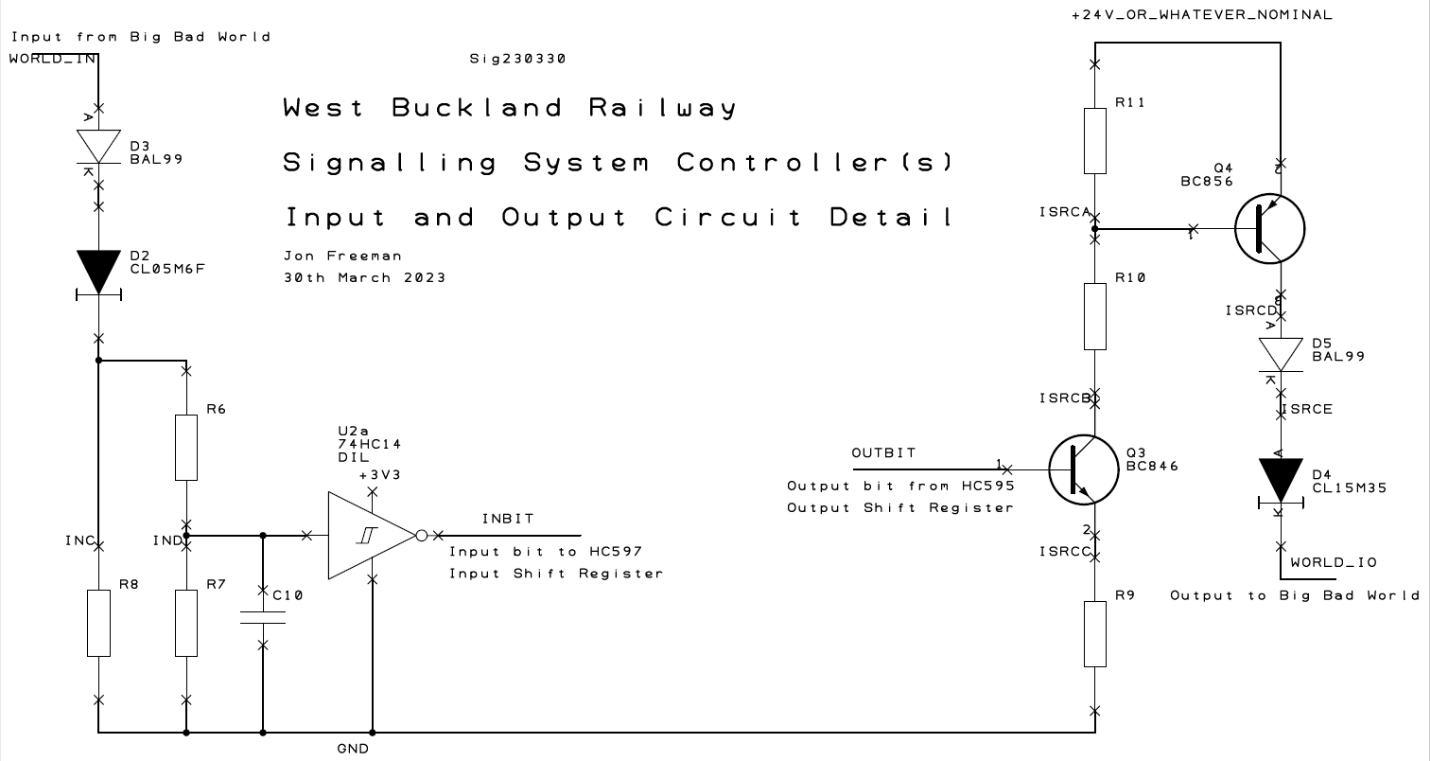
Electronics Hardware/Signals Controller/DaisyCore/Plots/WBSigs_IO_detail.png
