tauntonme/General/TME 1050 level crossing-Model.pdf

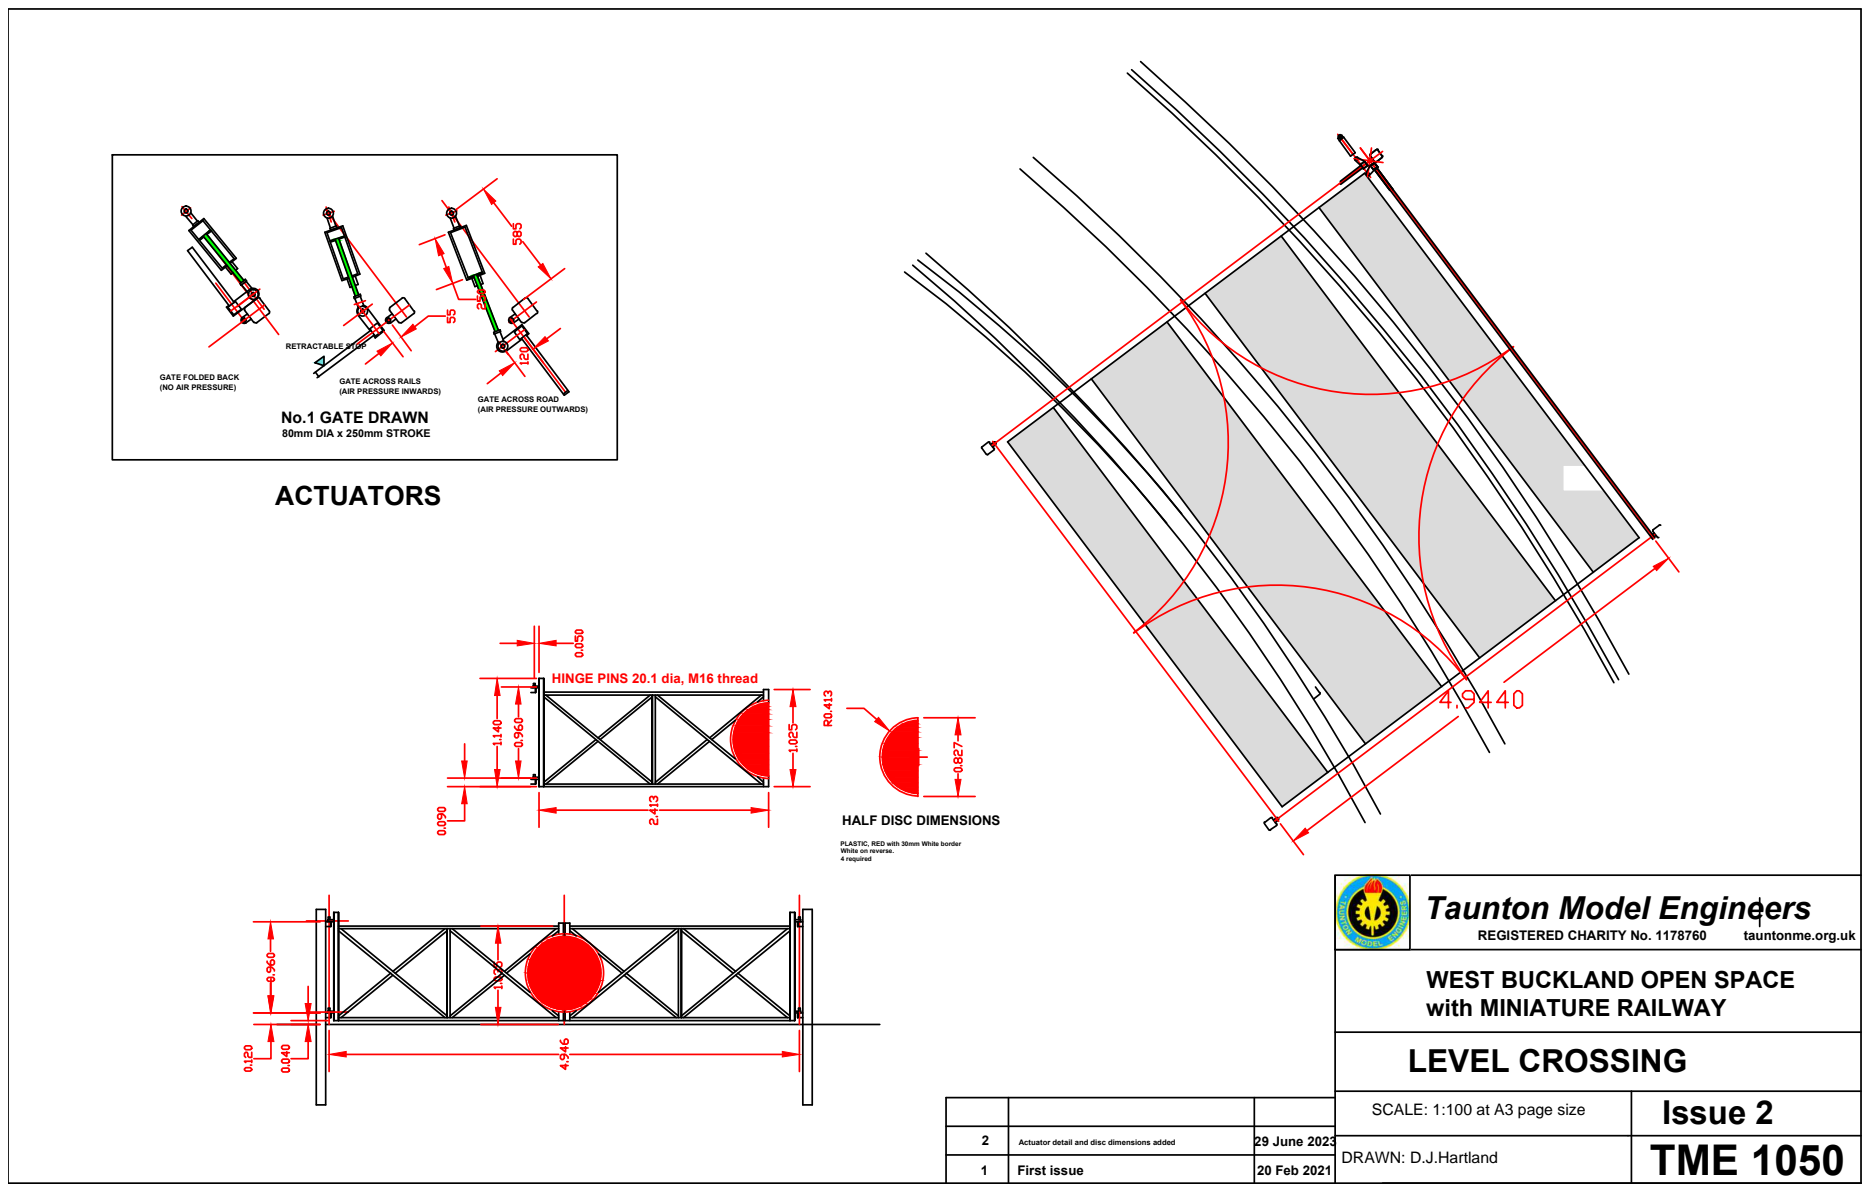
[picture p7: page 1]
REGISTERED CHARITY No. 1178760; tauntonme.org.uk; (NO AIR PRESSURE); GATE ACROSS RAILS; (AIR PRESSURE INWARDS); GATE ACROSS ROAD; RETRACTABLE STOP; 80mm DIA x 250mm STROKE

GATE FOLDED BACK

(AIR PRESSURE OUTWARDS) No.1 GATE DRAWN

HINGE PINS 20.1 dia, M16 thread

HALF DISC DIMENSIONS

PLASTIC, RED with 30mm White border White on reverse. 4 required

Taunton Model Engineers

WEST BUCKLAND OPEN SPACE
with MINIATURE RAILWAY
LEVEL CROSSING

SCALE: 1:100 at A3 page size | Issue 2

2 | Actuator detail and disc dimensions added | 29 June 2023

DRAWN: D.J.Hartland | TME 1050

1 | First issue | 20 Feb 2021
