tauntonme/General/TME 1067 Signal Box Diagram-Model.pdf

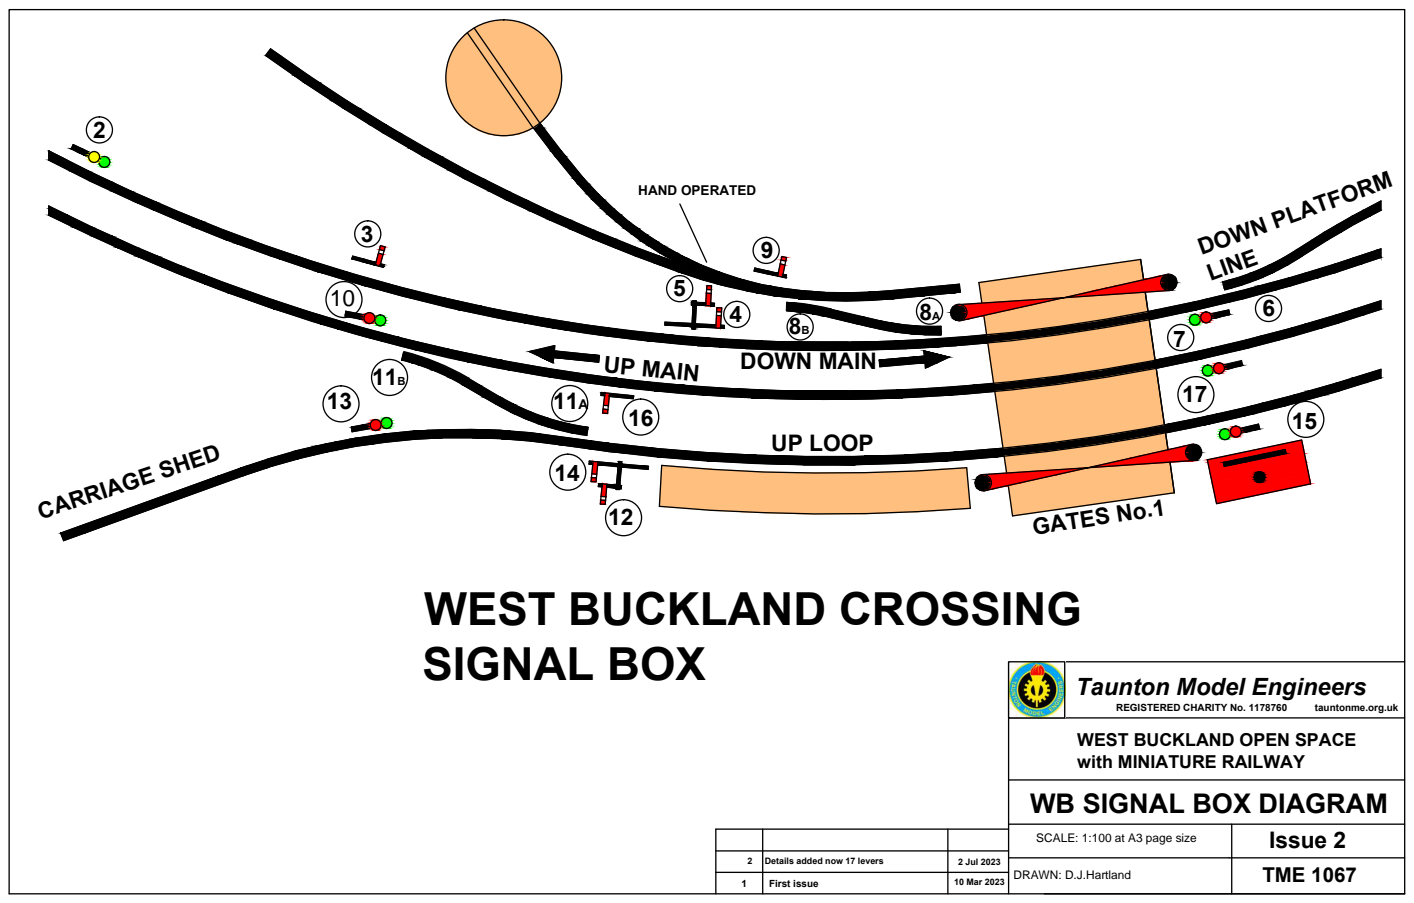
[picture p8: page 1]
REGISTERED CHARITY No. 1178760; tauntonme.org.uk; HAND OPERATED; UP LOOP

DOWN PLATFORM LINE

UP MAIN DOWN MAIN

CARRIAGE SHED GATES No.1

WEST BUCKLAND CROSSING
SIGNAL BOX

Taunton Model Engineers

WEST BUCKLAND OPEN SPACE
with MINIATURE RAILWAY
WB SIGNAL BOX DIAGRAM

SCALE: 1:100 at A3 page size | Issue 2

2 | Details added now 17 levers | 2 Jul 2023

DRAWN: D.J.Hartland | TME 1067

1 First issue | | 10 Mar 2023
