tauntonme/General/Electronics Hardware/Signals Controller/DaisyCore/Plots/Daisies - Drill Ident Drawing - [Through Hole] - PCB.pdf

C10

C11

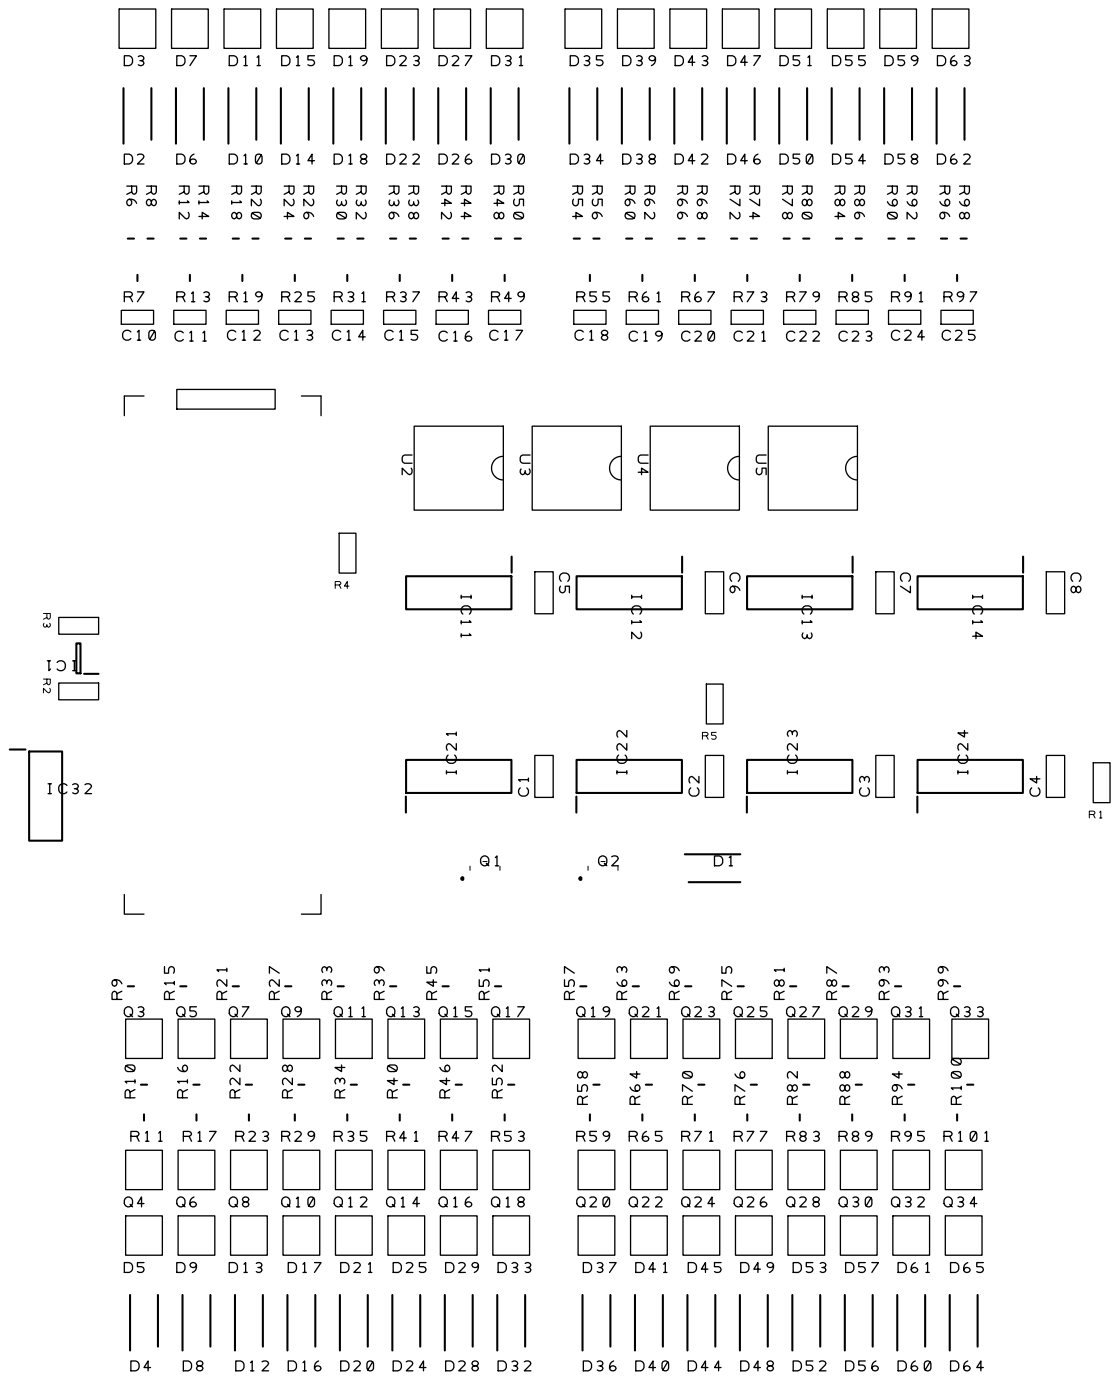
[picture p9: page 1]

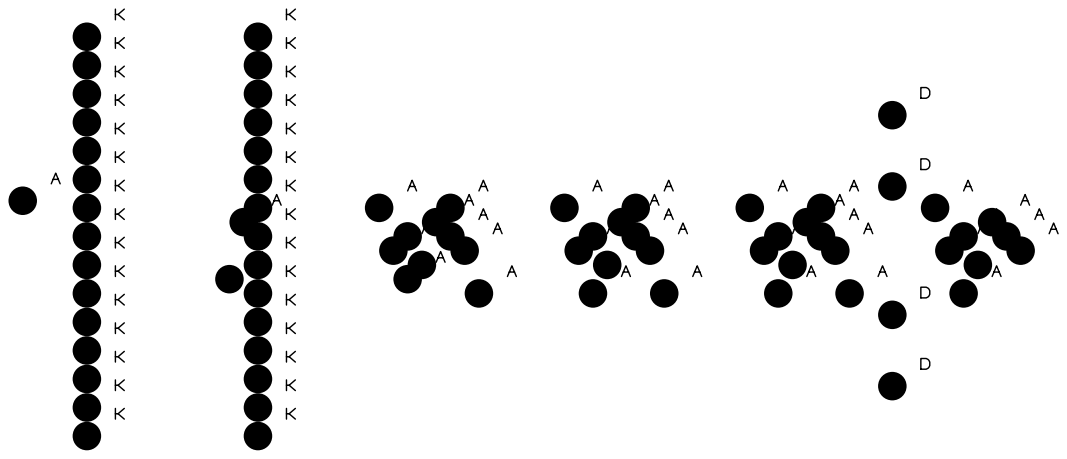
[picture p10: page 2]
