tauntonme/General/Electronics Hardware/Signals Controller/DaisyCore/Plots/Daisies_Ins - Daisies_Ins - Schematic.pdf

D3

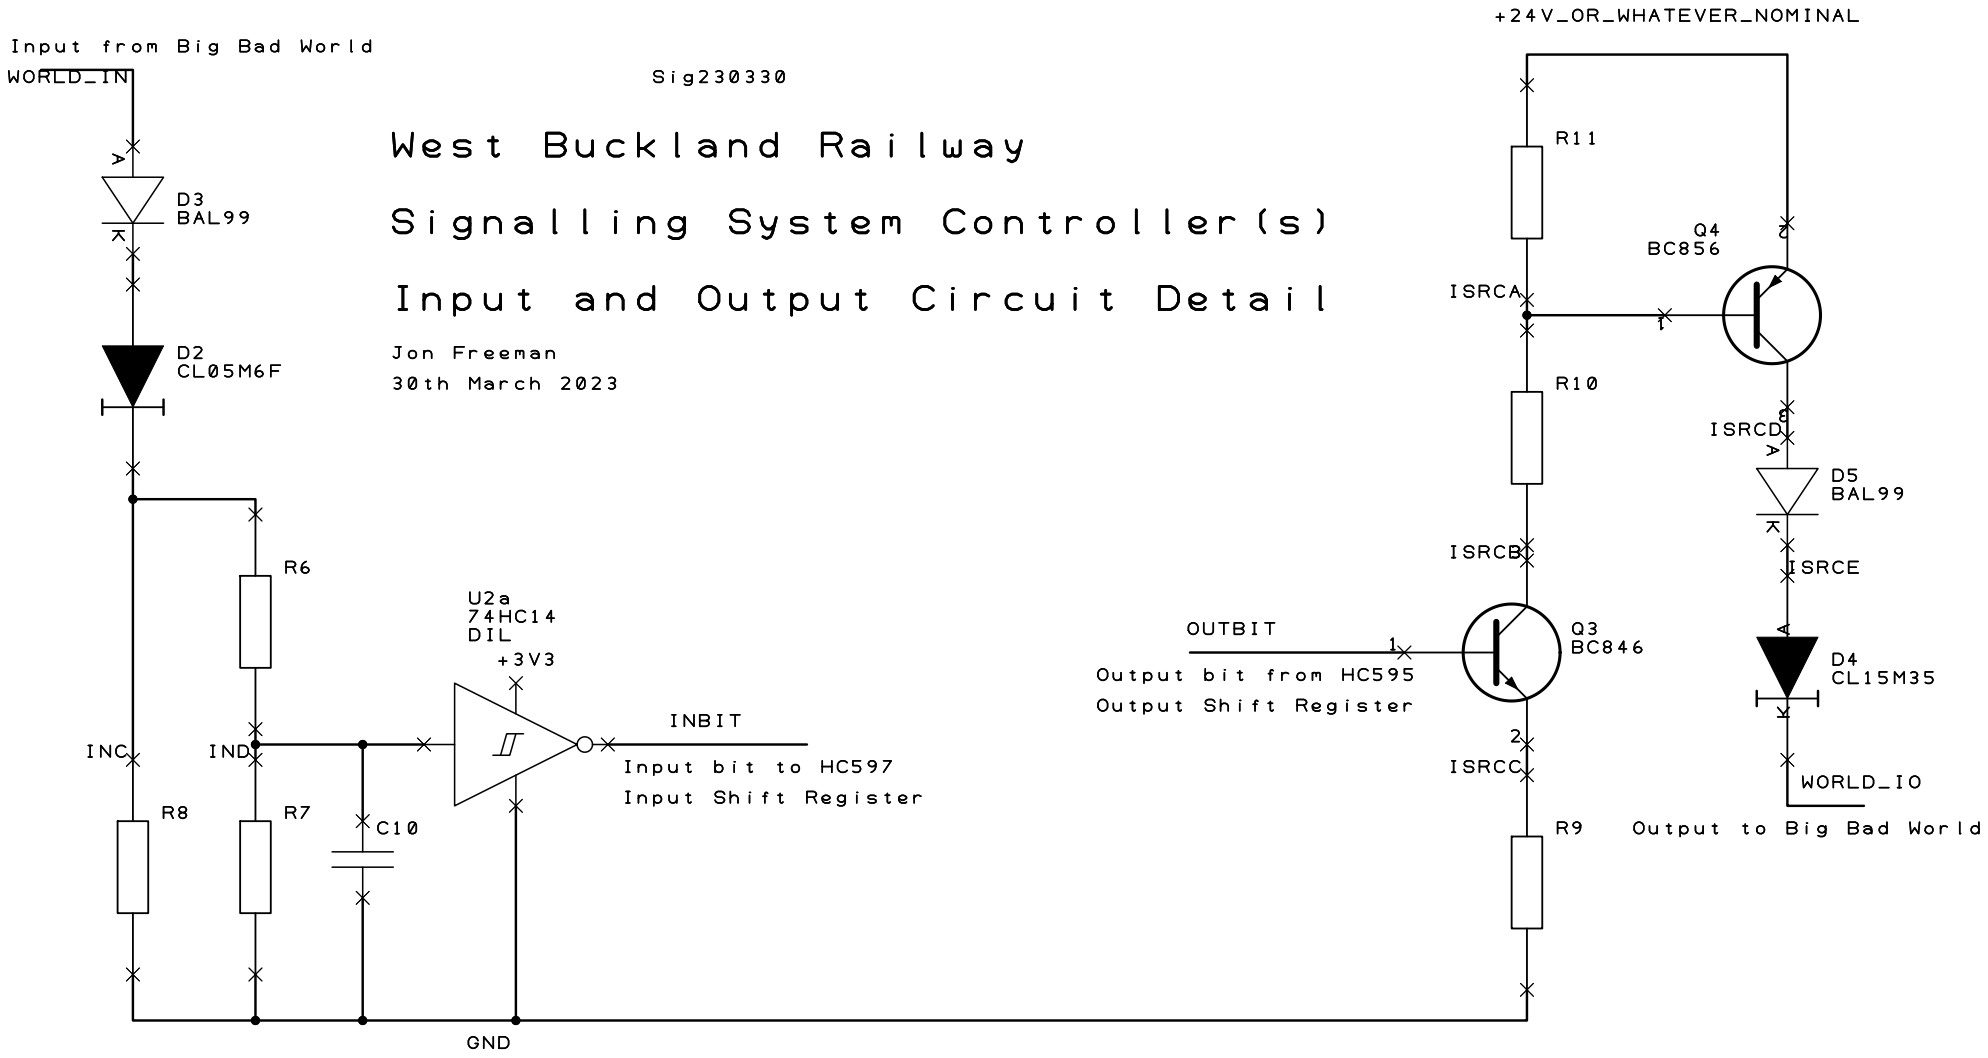
[picture p11: page 1]
