tauntonme/General/(list of files, drawings)

Other design files:
Electronics Hardware/Signals Controller/DaisyCore/Daisies2.pcb
Electronics Hardware/Signals Controller/DaisyCore/DaisyCore.pcb
Electronics Hardware/Signals Controller/DaisyCore/~DaisyCore.pcb
Electronics Hardware/Signals IO Expander/DaisyIOFINAL/DaisyIOFINAL.pcb
Electronics Hardware/Signals IO Expander/DaisyIOFINAL/~DaisyIOFINAL.pcb
